Franck78/SANWA-PM1745/xinwa-BX6341-12p.jpg

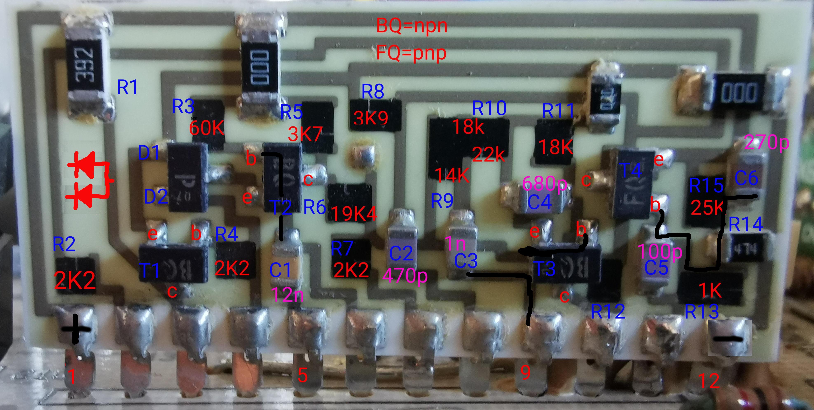
xinwa-BX6341-12p.jpg
