Franck78/SANWA-PM1745/xinwa-BX6341-15p.jpg

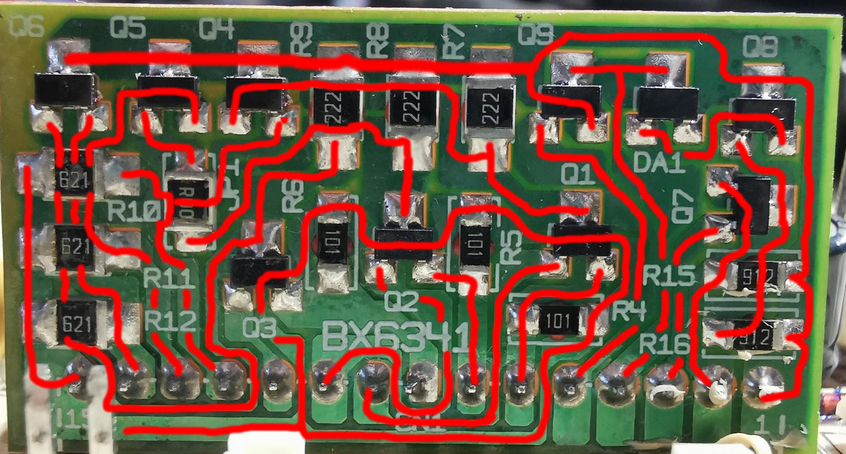
xinwa-BX6341-15p.jpg
