Franck78/SANWA-PM1745/sanwa-pm1745.ods

Sheet: sanwa-pm1745
C101 | 1µ/50v
C102 | 1µ/50v
C103 | 47µ/25v
C104 | 22n
C105 | 18n
C106 | 180p
C107 | 10µ/16v
C108 | 10µ/16v
C109 | 47µ/25v
C110 | 1000µ/25v
C111 | 47µ/200v
C113 | 22n/200v
C114 | 3µ3/16v
C115 | 3µ3/16v
C116 | 3µ3/16v
C301 | 3n3
C302 | 6µ8/35v
C303 | 390p
C304 | 10n
C305 | 100µ/35v
C306 | 1µ/25v
C307 | 6n8/100v
C308 | 1µ/50v
C309 | 22n/100v
C310 | 220µ/16v
C311 | 47n/100v
C312 | 470µ/50v
C313 | 100µ/35v
C314 | 330µ/50v
C401 | 3n6
C402 | 4n7
C403 | 15n/100v
C404 | 22n/100v
C405 | 10n
C406 | 47µ/35v
C407 | 1µ
C408 | 330µ/16v
C409 | 18n/1kv
C411 | 1n/1kv
C412 | 1n/1kv
C413 | 4n7/1500v
C414 | 10µ/50v
C415 | 47µ/25v
C416 | 10µ/50v
C417 | 10µ/50v
C418 | 47µ/35v
C419 | 10n
C420 | 1n5/100v
C421 | 1n/100v
C422 | 4µ7/63v
C423 | 330n/200v
C424 | 1µ/50v
C425 | 100n/100v
C426 | 220µ/50v
C427 | 470n/250v
C428 | 1µ/200v
C429 | 6n8/1.6kv
C430 | 6n8/630v
C431 | 6n8/1.6kv
C432 | 2n2/1.6kv
C433 | 10n/1.6kv
C434 | 6n8/630v
C435 | 470n/200v
C436 | 470p/2000v
C437 | 22n/100v
C438 | 22n/100V
C439 | 12n/200v
C440 | 1n/1kv
C441 | 1µ/250v
C801 | 100n
C802 | 1n 2Kv
C803 | 1n 2Kv
C804 | 4n7 1Kv
C805 | 4n7 1Kv
C806 | 680µ/200v
C807 | 1n
C808 | 100µ/200v
C809 | 1n
C810 | 1n
C811 | 3µ3/50v
C812 | 100µ/200v
C813 | 220µ/35v
C814 | 220µ/35v
C815 | 4n7/2Kv
C901 | 68p
C902 | 68p
C903 | 68p
C904 | 150p
C905 | 150p
C906 | 150p
C907 | 330p/1000v
C908 | 10n/160v
C909 | 4µ7/160v
CL1 | COIL
CL2 | COIL
CN101 | Conn_01x06_Female
CN102 | Conn_01x05_Male
CN103 | Conn_01x10_Female
CN104 | Conn_01x10_Male
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
VR202 | 5k
VR203 | 5k
VR341 | 5K
VR342 | 5K
VR343 | 10K
VR351 | 10K
VR353 | 100K
VR354 | 100K
VR451 | 2K
VR452 | 1K
VR453 | 1K
VR454 | 20K
VR455 | 50K
VR481 | 4K7
VR851 | 4K7
WIRESCN101 | Conn_01x06_Male
WIRESCN102 | Conn_01x05_Female
WIRESCN403 | Conn_01x03_Female
WIRESCN801 | Conn_01x02_Male

Sheet: Fuse Resistors
F 4 "Flamproof" H 13950 1100 50 0001 C CNN "Options"
R129 | 3.9 | 1/2W flameproof
R130 | 3.9 | 1/2W flameproof
R311 | 180 | 1/2W flameproof
R313 | 390 | 1/2W flameproof
R315 | 3.3 | 1/2W flameproof
R448 | 330 | 1/2W flameproof
R451 | 2K7 | 1/2W flameproof
R813 | 68K | 1/2W flameproof
R314 | 150 | 1/4W flameproof
R437 | 100 | 1/4W flameproof
R805 | 1K5 | 1/4W flameproof
R806 | 68 | 1/4W flameproof
R816 | 75 | 1/4W flameproof
R817 | 1K5 | 1/4W flameproof
R922 | 15 | 1/4W flameproof
R923 | 15 | 1/4W flameproof
R924 | 15 | 1/4W flameproof
R419 | .22 | 1W flameproof
R131 | 5.6 | 2W flameproof
R312 | 3.9 | 3W flameproof
R415 | 5K6 | 3W flameproof
R416 | 1K8 | 3W flameproof
R417 | 1K8 | 3W flameproof
R442 | 0.47 | 3W flameproof
R919 | 3K9 | 5W flameproof
R920 | 3K9 | 5W flameproof
R921 | 3k9 | 5W flameproof

Sheet: Capkit
C114 (T) | 3µ3 | 16v | 3µ3/16vT
C115 (T) | 3µ3 | 16v | 3µ3/16vT
C116 (T) | 3µ3 | 16v | 3µ3/16vT
C107 | 10µ | 16v | 10µ/16v
C108 | 10µ | 16v | 10µ/16v
C310 | 220µ | 16v | 220µ/16v
C408 | 330µ | 16v | 330µ/16v
C306 (T) | 1µ | 25v | 1µ/25vT
C103 | 47µ | 25v | 47µ/25v
C109 | 47µ | 25v | 47µ/25v
C415 | 47µ | 25v | 47µ/25v
C110 | 1000µ | 25v | 1000µ/25v
C302 (T) | 6µ8 | 35v | 6µ8/35vT
C406 | 47µ | 35v | 47µ/35v
C418 | 47µ | 35v | 47µ/35v
C305 | 100µ | 35v | 100µ/35v
C313 | 100µ | 35v | 100µ/35v
C813 | 220µ | 35v | 220µ/35v
C814 | 220µ | 35v | 220µ/35v
C101 | 1µ | 50v | 1µ/50v
C102 | 1µ | 50v | 1µ/50v
C308 | 1µ | 50v | 1µ/50v
C407 | 1µ | 50v | 1µ/50v
C424 | 1µ | 50v | 1µ/50v
C811 | 3µ3 | 50v | 3µ3/50v
C414 | 10µ | 50v | 10µ/50v
C416 | 10µ | 50v | 10µ/50v
C417 | 10µ | 50v | 10µ/50v
C426 | 220µ | 50v | 220µ/50v
C314 | 330µ | 50v | 330µ/50v
C312 | 470µ | 50v | 470µ/50v
C909 | 4µ7 | 160v | 4µ7/160v
C111 | 47µ | 200v | 47µ/200v
C808 | 100µ | 200v | 100µ/200v
C812 | 100µ | 200v | 100µ/200v
C806 | 680µ | 200v | 680µ/200v
C428 | 1µ | 250v | 1µ/250v
C441 | 1µ | 250v | 1µ/250v

Sheet: Feuille4
R101 | R401 | R801 | R901 | R301 | C101 | C301 | C401 | C801 | C901
R102 | R402 | R802 | R902 | R302 | C102 | C302 | C402 | C802 | C902
R103 | R403 | R803 | R903 | R303 | C103 | C303 | C403 | C803 | C903
R104 | R404 | R804 | R904 | R304 | C104 | C304 | C404 | C804 | C904
R105 | R405 | R805 | R905 | R305 | C105 | C305 | C405 | C805 | C905
R106 | R406 | R806 | R906 | R306 | C106 | C306 | C406 | C806 | C906
R107 | R407 | R807 | R907 | R307 | C107 | C307 | C407 | C807 | C907
R108 | R408 | R808 | R908 | R308 | C108 | C308 | C408 | C808 | C908
R109 | R409 | R809 | R909 | R309 | C109 | C309 | C409 | C809 | C909
R110 | R410 | R810 | R910 | R310 | C110 | C310 | C410 | C810
R111 | R411 | R811 | R911 | R311 | C111 | C311 | C411 | C811
R112 | R412 | R812 | R912 | R312 | xxxx | C312 | C412 | C812
R113 | R413 | R813 | R913 | R313 | C113 | C313 | C413 | C813
R114 | R414 | R814 | R914 | R314 | C114 | C314 | C414 | C814
R115 | R415 | R815 | R915 | R315 | C115 |  | C415 | C815
R116 | R416 | R816 | R916 | R316 | C116 |  | C416
R117 | R417 | R817 | R917 | R317 |  |  | C417
R118 | R418 | R818 | R918 |  |  |  | C418
R119 | R419 | R819 | R919 |  |  |  | C419
R120 | R420 |  | R920 |  |  |  | xxxx
R121 | R421 |  | R921 |  |  |  | C421
R122 | R422 |  | R922 |  |  |  | C422
R123 | R423 |  | R923 |  |  |  | C423
R124 | R424 |  | R924 |  |  |  | C424
R125 | R425 |  | R925 |  |  |  | C425
R126 | R426 |  | R926 |  |  |  | C426
R127 | R427 |  | R927 |  |  |  | C427
R128 | R428 |  | R928 |  |  |  | C428
R129 | R429 |  |  |  |  |  | C429
R130 | R430 |  |  |  |  |  | C430
R131 | R431 |  |  |  |  |  | C431
R132 | R432 |  |  |  |  |  | C432
R133 | R433 |  |  |  |  |  | C433
R134 | R434 |  |  |  |  |  | C434
R135 | R435 |  |  |  |  |  | C435
R136 | R436 |  |  |  |  |  | C436
 | R437 |  |  |  |  |  | C437
 | R438 |  |  |  |  |  | C438
 | R439 |  |  |  |  |  | C439
 | R440 |  |  |  |  |  | C440
 | R441 |  |  |  |  |  | C441
 | R442
 | R443
 | R444
 | R445
 | R446
 | R447
 | R448
 | R449
 | R450
 | R451
 | xxxx
 | R453
 | R454
 | R455
 | R456
 | R457
 | R458
 | R459
 | R460
 | R461
