Franck78/SANWA-PM1745/sanwa-pm1745.pdf

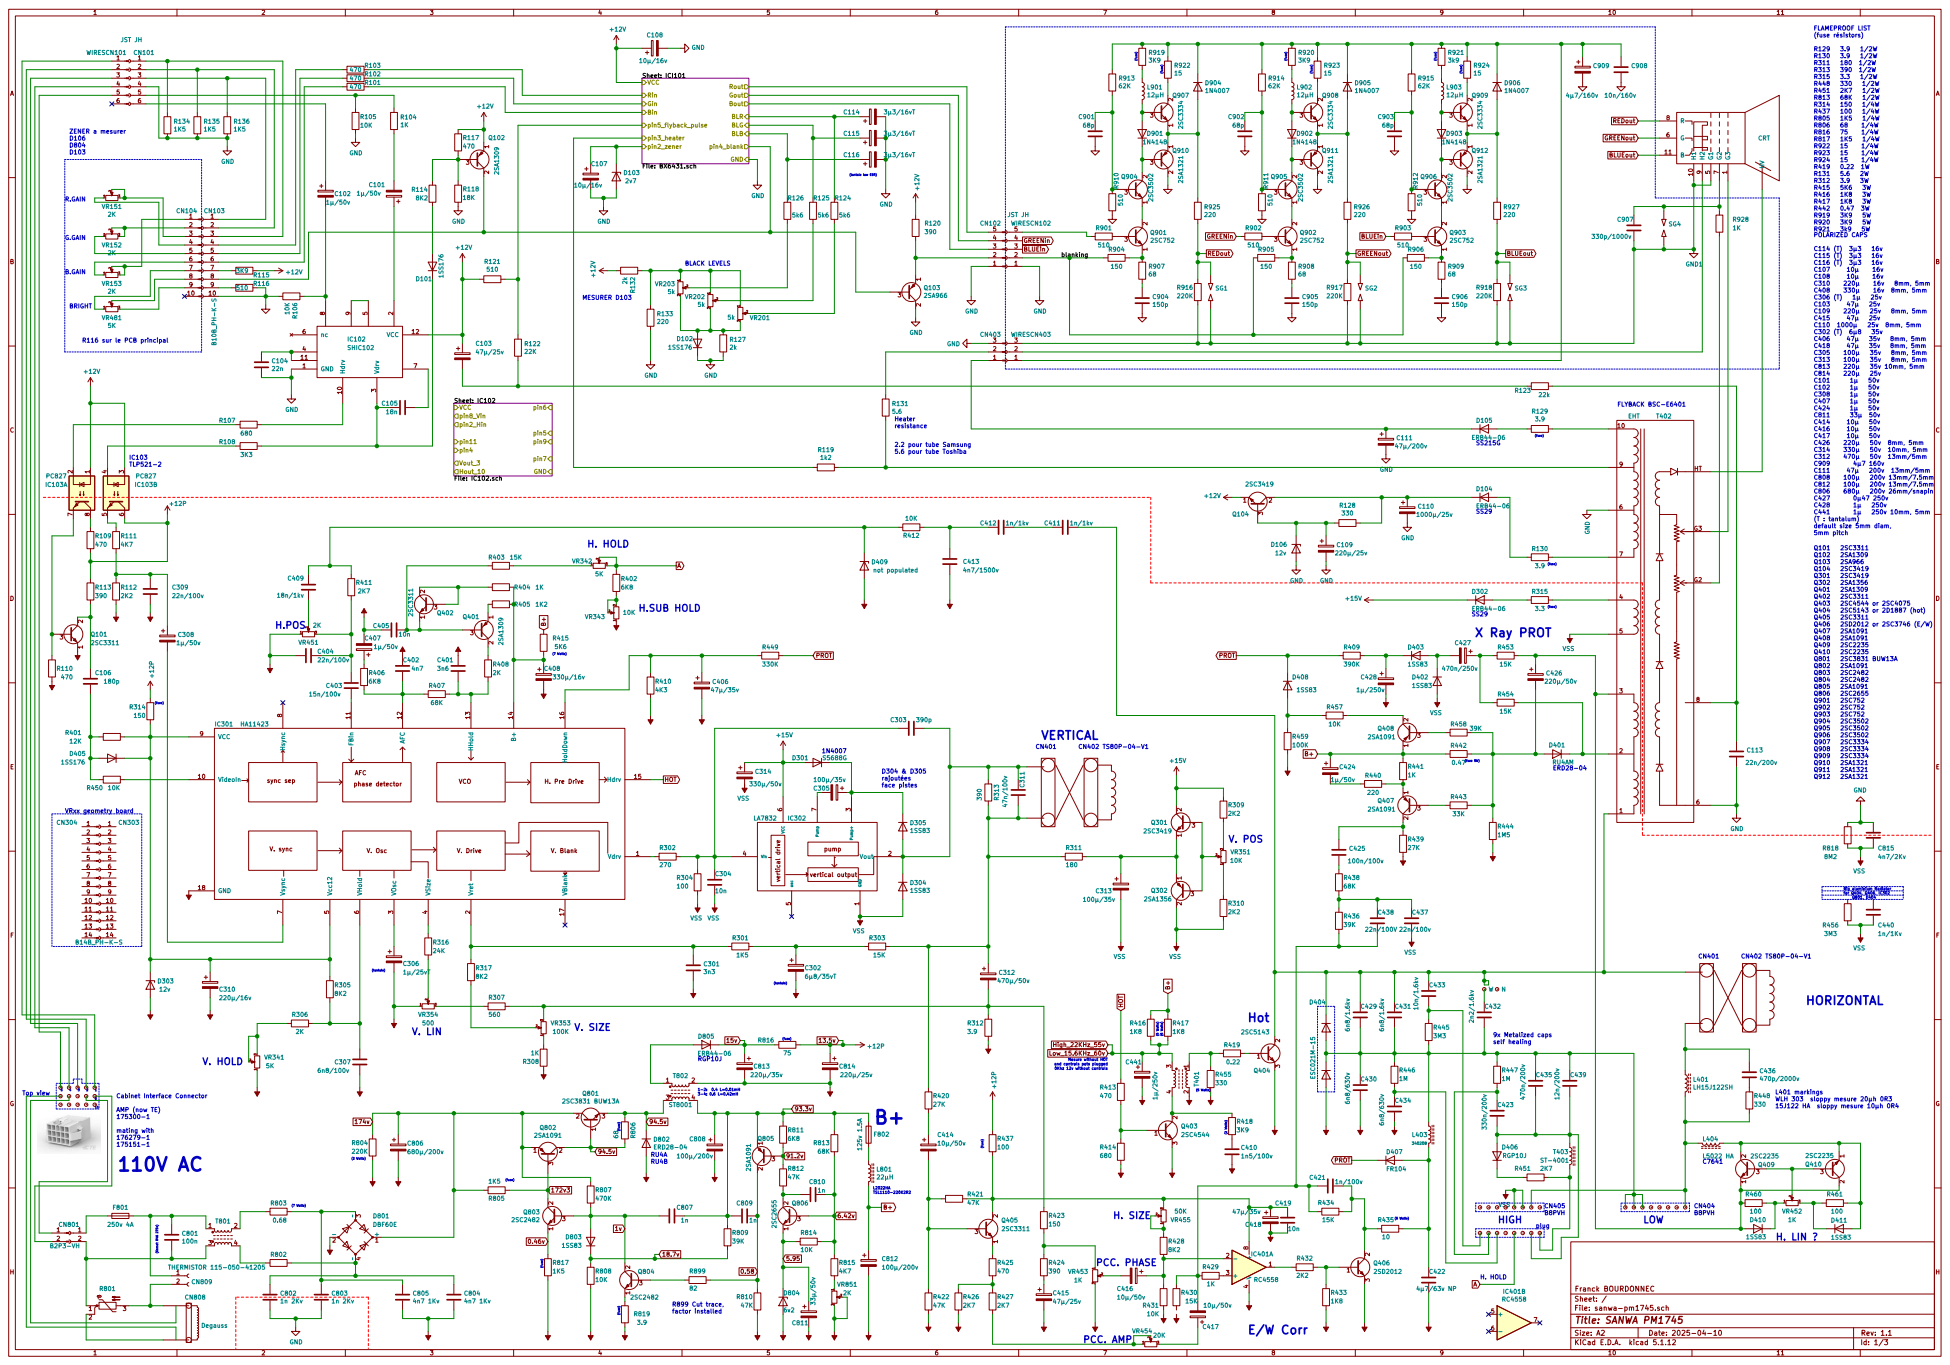
[picture p3: page 1]

(T : tantalum) default size 5mm diam, 5mm pitch (fuse)

R116 sur le PCB principal

Sheet: IC102 File: IC102.sch VCC

Q101 2SC3311 Q102 2SA1309 Q103 2SA966 Q104 2SC3419 Q301 2SC3419 Q302 2SA1356 Q401 2SA1309 Q402 2SC3311 Q403 2SC4544 or 2SC4075 Q404 2SC5143 or 2D1887 (hot) Q405 2SC3311 Q406 2SD2012 or 2SC3746 (E/W) Q407 2SA1091 Q408 2SA1091 Q409 2SC2235 Q410 2SC2235 Q801 2SC3831 BUW13A Q802 2SA1091 Q803 2SC2482 Q804 2SC2482 Q805 2SA1091 Q806 2SC2655 Q901 2SC752 Q902 2SC752 Q903 2SC752 Q904 2SC3502 Q905 2SC3502 Q906 2SC3502 Q907 2SC3334 Q908 2SC3334 Q909 2SC3334 Q910 2SA1321 Q911 2SA1321 Q912 2SA1321 (5 Watts) Mesure without HOT

CN402 TS80P-04-V1 Cabinet Interface Connector AMP (now TE) 175300-1 mating with

and controls pots plugged
0Khz 12v without controls

File: sanwa-pm1745.sch Sheet: / Franck BOURDONNEC

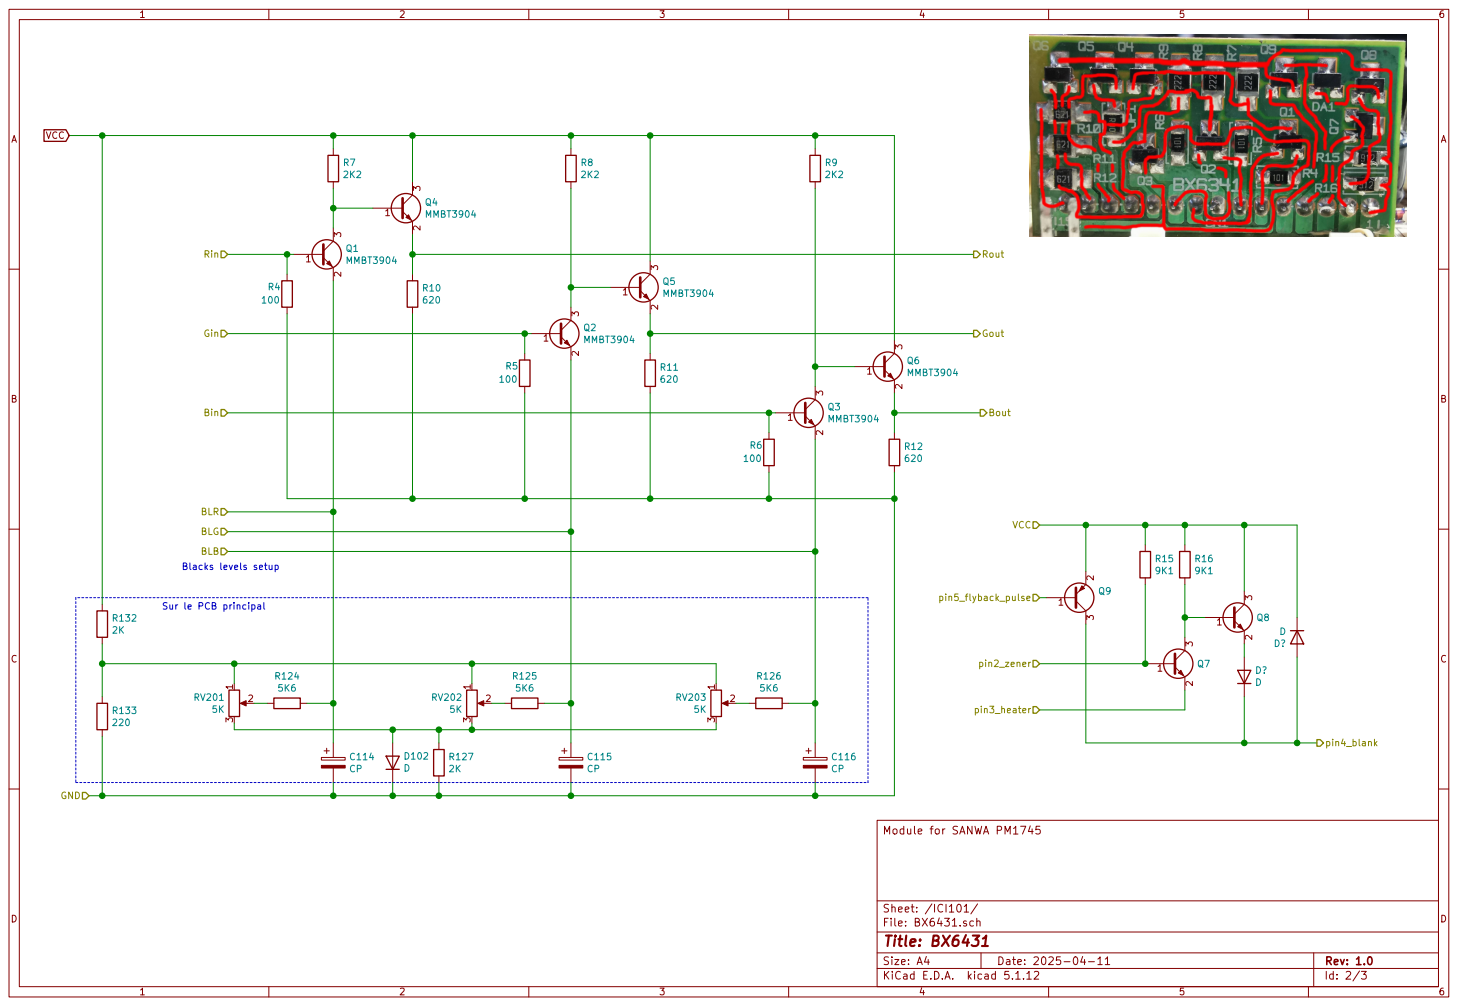
[picture p4: page 2]

File: BX6431.sch Sheet: /ICI101/ Module for SANWA PM1745 C116 CP R11

pin5_flyback_pulse BLB

Sur le PCB principal | | 5K6

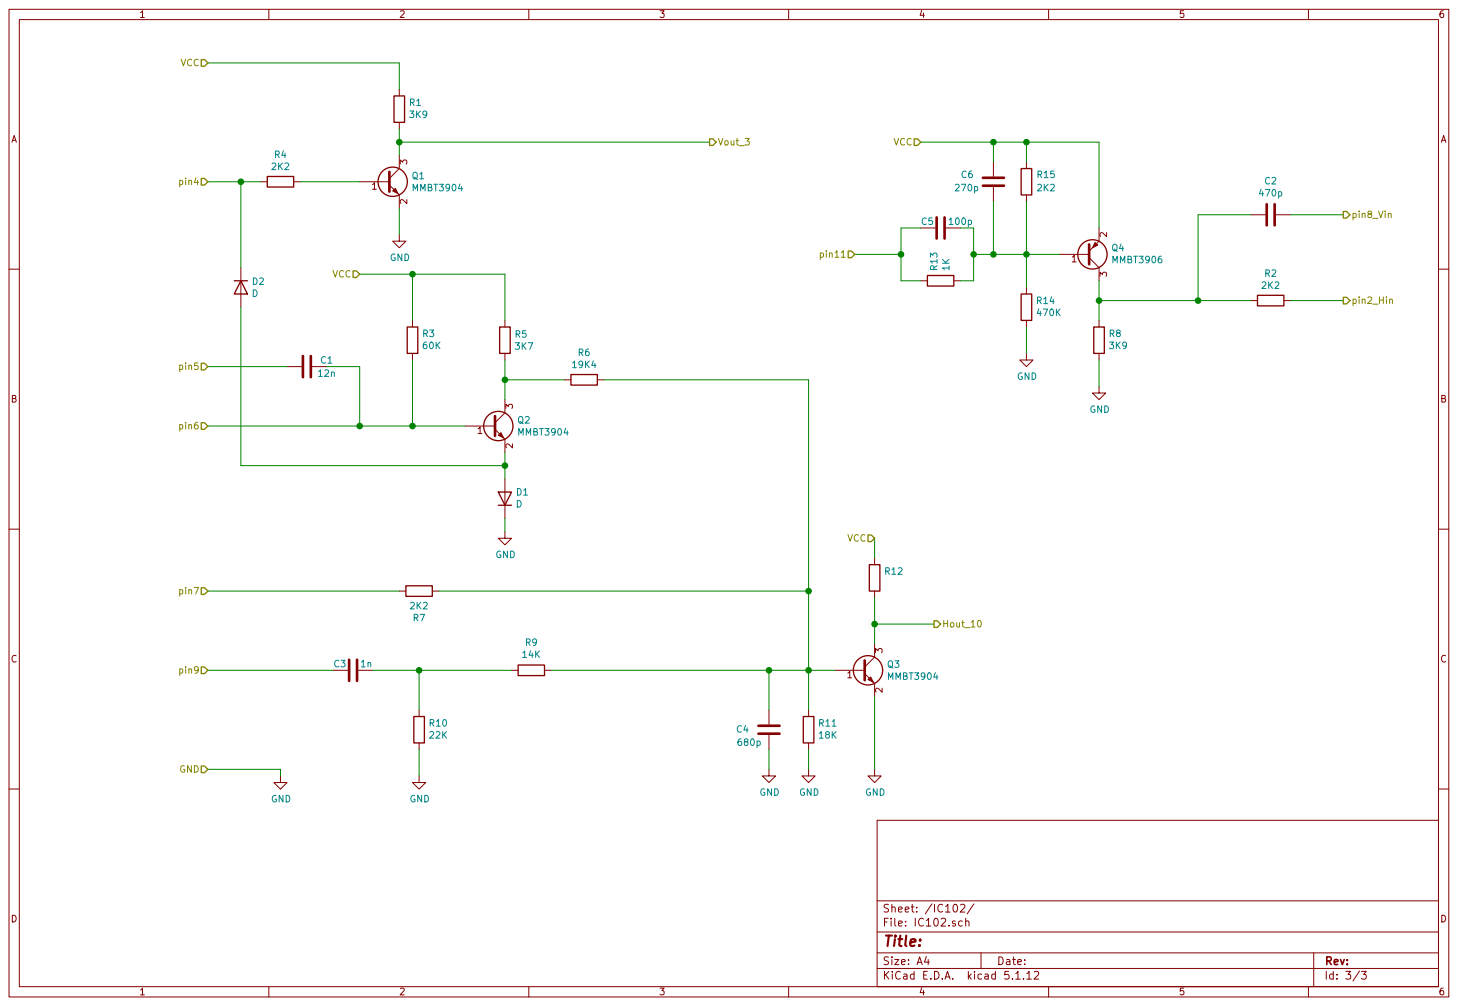
[picture p5: page 3]

Id: 3/3 Title: File: IC102.sch Sheet: /IC102/
