Franck78/SANWA-PM1745/BX6431.sch

## KiCad design BX6431.sch (2025-04-12)

Schematic: BX6431.sch

Parts:
C114, C115, C116: CP
D102: D
Q1, Q2, Q3, Q4, Q5, Q6, Q7, Q8: MMBT3904; SOT-23
Q9: MMBT3906; SOT-23
R4, R5, R6: 100
R7, R8, R9: 2K2
R10, R11, R12: 620
R15, R16: 9K1
R124, R125, R126: 5K6
R127, R132: 2K
R133: 220
RV201, RV202, RV203: 5K

Notes on the sheet:
Blacks levels setup
Sur le PCB principal
