Franck78/SANWA-PM1745/IC102.sch

## KiCad design IC102.sch (2025-04-12)

Schematic: IC102.sch

Parts:
C1: 12n
C2: 470p
C3: 1n
C4: 680p
C5: 100p
C6: 270p
D1, D2: D
Q1, Q2, Q3: MMBT3904; SOT-23
Q4: MMBT3906; SOT-23
R1, R8: 3K9
R2, R4, R7, R15: 2K2
R3: 60K
R5: 3K7
R6: 19K4
R9: 14K
R10: 22K
R11: 18K
R12: (no value)
R13: 1K
R14: 470K
