Franck78/SANWA-PM1745/sanwa-pm1745.sch

## KiCad design sanwa-pm1745.sch (2025-05-07)

Schematic: sanwa-pm1745.sch

Parts:
C101, C102, C308, C407, C424: 1µ/50v
C103, C415: 47µ/25v
C104: 22n
C105: 18n
C106: 180p
C107, C108: 10µ/16v
C109, C814: 220µ/25v
C110: 1000µ/25v
C111: 47µ/200v
C113: 22n/200v
C114, C115, C116: 3µ3/16vT
C301: 3n3
C302: 6µ8/35vT
C303: 390p
C304, C405, C419: 10n
C305, C313: 100µ/35v
C306: 1µ/25vT
C307: 6n8/100v
C309, C404, C437: 22n/100v
C310: 220µ/16v
C311: 47n/100v
C312: 470µ/50v
C314: 330µ/50v
C401: 3n6
C402: 4n7
C403: 15n/100v
C406, C418: 47µ/35v
C408: 330µ/16v
C409: 18n/1kv
C410: 1n5/100v
C411, C412: 1n/1kv
C413: 4n7/1500v
C414, C416, C417: 10µ/50v
C421: 1n/100v
C422: 4µ7/63v NP
C423: 330n/200v
C425: 100n/100v
C426: 220µ/50v
C427: 470n/250v
C428, C441: 1µ/250v
C429, C431: 6n8/1.6kv
C430, C434: 6n8/630v
C432: 2n2/1.6kv
C433: 10n/1.6kv
C435: 470n/200v
C436: 470p/2000v
C438: 22n/100V
C439: 12n/200v
C440: 1n/1Kv
C801: 100n
C802, C803: 1n 2Kv
C804, C805: 4n7 1Kv
C806: 680µ/200v
C807, C809, C810: 1n
C808, C812: 100µ/200v
C811: 33µ/50v
C813: 220µ/35v
C815: 4n7/2Kv
C901, C902, C903: 68p
C904, C905, C906: 150p
C907: 330p/1000v
C908: 10n/160v
C909: 4µ7/160v
CL1, CL2: COIL
CN101: JST JH
CN102: Conn_01x05_Male
CN103: B10B_PH-K-S
CN104: Conn_01x10_Male
CN303: B14B_PH-K-S
CN304: Conn_01x14_Male
CN403: Conn_01x03_Male
CN801: B2P3-VH
CN808: Degauss
CN809: Conn_01x02_Female
D101, D102, D405: 1SS176
D103: 2v7
D104, D105, D302: ERB44-06; D_DO-41_SOD81_P10.16mm_Horizontal
D106, D303: 12v
D301: S5688G
D304, D305, D803: 1SS83
D401: RU4AM; D_DO-41_SOD81_P10.16mm_Horizontal
D402, D403, D408, D410, D411: 1SS83; D_DO-41_SOD81_P10.16mm_Horizontal
D404: ESC021M-15; D_DO-41_SOD81_P10.16mm_Horizontal
D404-2: 2SC021M; D_DO-41_SOD81_P10.16mm_Horizontal
D406: RGP10J; D_DO-41_SOD81_P10.16mm_Horizontal
D407: FR104; D_DO-41_SOD81_P10.16mm_Horizontal
D409: not populated
D801: DBF60E
D802: ERD28-04; D_DO-41_SOD81_P10.16mm_Horizontal
D804: 6v2
D805: ERB44-06
D901, D902, D903: 1N4148
D904, D905, D906: 1N4007; D_DO-41_SOD81_P10.16mm_Horizontal
F801: 250v 4A
F802: 125v 1.5A
IC102: SHIC102
IC103: PC827; DIP-8_W7.62mm
IC301: HA11423
IC302: LA7832
IC401: RC4558
L401: LH15J122SH
L403: 340208
L404: L5022 HA
L801: 22µH
L901, L902, L903: 12µH
Q101, Q402, Q405: 2SC3311
Q102, Q401: 2SA1309
Q103: 2SA966
Q104, Q301: 2SC3419; TO-126-3_Vertical
Q302: 2SA1356
Q403: 2SC4544; TO-126-3_Vertical
Q404: 2SC5143; TO-126-3_Vertical
Q406: 2SD2012
Q407, Q408, Q802, Q805: 2SA1091
Q409, Q410: 2SC2235; TO-92_Inline
Q801: 2SC3831 BUW13A
Q803, Q804: 2SC2482
Q806: 2SC2655
Q901, Q902, Q903: 2SC752; TO-92_Inline
Q904, Q905, Q906: 2SC3502; TO-126-3_Vertical
Q907, Q908, Q909: 2SC3334; TO-92_Inline
Q910, Q911, Q912: 2SA1321; TO-92_Inline
R101, R102, R103, R109, R110, R117, R413, R425: 470
R104, R308, R404, R429, R441, R928: 1K
R105, R106, R412, R431, R450, R457, R808, R814: 10K
R107, R414: 680
R108: 3K3
R111, R815: 4K7
R112, R309, R310, R432: 2K2
R113, R120, R313, R424: 390
R114, R305, R317, R428: 8K2
R115, R418, R919, R920: 3K9
R116, R121, R901, R902, R903, R910, R911, R912: 510
R118: 18K
R119: 1k2
R122: 22K
R123: 22k
R124, R125, R126: 5k6
R127, R132: 2k
R128, R448, R455: 330
R129, R130, R312, R819: 3.9
R131: 5.6
R133, R440, R925, R926, R927: 220
R134, R135, R136, R301, R805, R817: 1K5
R302: 270
R303, R403, R430, R434, R453, R454: 15K
R304, R437, R460, R461: 100
R306, R408: 2K
R307: 560
R311: 180
R314, R423, R904, R905, R906: 150
R315: 3.3
R316: 24K
R401: 12K
R402, R406, R811: 6K8
R405: 1K2
R407, R438, R813: 68K
R409: 390K
R410: 4K3
R411, R426, R427, R451: 2K7
R415: 5K6
R416, R417, R433: 1K8
R419: 0.22
R420, R439: 27K
R421, R422, R810, R812: 47K
R435: 10
R436, R458, R809: 39K
R442: 0.47
R443: 33K
R444: 1M5
R445, R456: 3M3
R446, R447: 1M
R449: 330K
R459: 100K
R801: 903051D050MP
R802: THERMISTOR 115-050-41205
R803: 0.68
R804, R916, R917, R918: 220K
R806, R907, R908, R909: 68
R807: 470K
R816: 75
R818: 8M2
R899: 82
R913, R914, R915: 62K
R921: 3k9
R922, R923, R924: 15
SG1, SG2, SG3, SG4: SPARK_GAP
T401: ETH19Y141AY
T402: EHT
T403: ST-4001
T801: L_Core_Ferrite_Coupled
T802: ST8001
TP1: W
TP2, TP3, TP4, TP5, TP6, TP7, TP8, TP9, TP10, TP11, TP12, TP13, TP14, TP15, TP16, TP17, TP18, TP19, TP20, TP21, TP22, TP23, TP24, TP25, TP26, TP27, TP28, TP29, TP30, TP31, TP32, TP33, TP34, TP35, TP36, TP37, TP38, TP39, TP40, TP41: N
Tube1: CRT
VR151, VR152, VR153, VR451, VR851: 2K
VR201, VR202, VR203: 5k
VR341, VR342, VR481: 5K
VR343, VR351: 10K
VR353: 100K
VR354: 500
VR452, VR453: 1K
VR454: 20K
VR455: 50K
WIRESCN101: Conn_01x06_Male
WIRESCN102: JST JH
WIRESCN403: Conn_01x03_Female
WIRESCN801: Conn_01x02_Male

Notes on the sheet:
(fuse)
(tantale low ESR)
MESURER D103
2.2 pour tube Samsung 5.6 pour tube Toshiba
Heater resistance
BLACK LEVELS
R.GAIN
G.GAIN
B.GAIN
BRIGHT
R116 sur le PCB principal
CN401
CN402 TS80P-04-V1
VERTICAL
D304 & D305 rajoutées face pistes
(tantale)
(Kemet R46 275v)
(2 Watts)
RU4A RU4B
ZENER a mesurer D106 D804 D103
H.POS
(7 Watts)
H. HOLD
H.SUB HOLD
V. LIN
V. HOLD
ERD28-04
(fuse 5W)
(5 Watts)
PCC. PHASE
H. SIZE
HORIZONTAL
PCC. AMP
V. SIZE
V. POS
X Ray PROT
CN404 B8PVH
LOW
CN405 B8PVH
HIGH
E/W Corr
FLYBACK BSC-E6401
plug
Cabinet Interface Connector AMP (now TE) 175300-1 mating with 176279-1 175151-1
Top view
9x Metalized caps self healing
FLAMEPROOF LIST (fuse résistors) R129 3.9 1/2W R130 3.9 1/2W R311 180 1/2W R313 390 1/2W R315 3.3 1/2W R448 330 1/2W R451 2K7 1/2W R813 68K 1/2W R314 150 1/4W R437 100 1/4W R805 1K5 1/4W R806 68 1/4W R816 75 1/4W R817 1K5 1/4W R922 15 1/4W R923 15 1/4W R924 15 1/4W R419 0.22 1W R131 5.6 2W R312 3.9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
POLARIZED CAPS C114 (T) 3µ3 16v C115 (T) 3µ3 16v C116 (T) 3µ3 16v C107 10µ 16v C108 10µ 16v C310 220µ 16v 8mm, 5mm C408 330µ 16v 8mm, 5mm C306 (T) 1µ 25v C103 47µ 25v C109 220µ 25v 8mm, 5mm C415 47µ 25v C110 1000µ 25v 8mm, 5mm C302 (T) 6µ8 35v C406 47µ 35v 8mm, 5mm C418 47µ 35v 8mm, 5mm C305 100µ 3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
Hot
H. LIN ?
R899 Cut trace, factor installed
110V AC
for Q404, Q406, IC302
Big aluminium Radiator
Q801, D404
L401 markings WLH 303 sloppy mesure 20µh 0R3 15J122 HA sloppy mesure 10µh 0R4
C7641
L2022HA TSL1110-220K2R2
SS215G
SS29
1N4007
RGP10J
IC103 TLP521-2
VRxx geometry board
1-2: 0.4 L=0.01mH 3-4: 0.6 L=0.42mH
Mesure without HOT and controls pots plugged 0Khz 12v without controls
Q101 2SC3311 Q102 2SA1309 Q103 2SA966 Q104 2SC3419 Q301 2SC3419 Q302 2SA1356 Q401 2SA1309 Q402 2SC3311 Q403 2SC4544 or 2SC4075 Q404 2SC5143 or 2D1887 (hot) Q405 2SC3311 Q406 2SD2012 or 2SC3746 (E/W) Q407 2SA1091 Q408 2SA1091 Q409 2SC2235 Q410 2SC2235 Q801 2SC3831 BUW13A Q802 2SA1091 Q803 2SC2482 Q8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
