Franck78/SANWA-PM1745/(commit log)

2025-04-12 Add files via upload
    Initial release
    [BX6431.sch, IC102.sch, sanwa-pm1745.ods, sanwa-pm1745.sch]
2025-05-07 Some minor fixes
    [sanwa-pm1745.sch]
